mas463-cpu/ECET-230-Project/tasks/README.md

# Task List

## High Priority
- Interface MPU6050 with Arduino Leonardo
- Read and process gyroscope data
- Map motion data to cursor movement
- Implement mouse click functionality

## Medium Priority
- Implement scroll functionality
- Add cursor reset feature
- Tune sensitivity and smoothing

## Low Priority
- Add LED status indicator
- Improve ergonomics of device
- Clean up code and documentation

## Dependencies
- Gyroscope must be functioning before cursor mapping
- USB HID mouse functionality must be implemented before testing

## Completed Tasks

- Created initial KiCad schematic
- Added ATmega32U4 microcontroller connections
- Added MPU6050 gyroscope interface
- Routed USB D+ and D- traces
- Added 3.3V power routing and ground plane
- Completed multi-layer PCB routing
- Uploaded PCB screenshots and project documentation
