mas463-cpu/ECET-230-Project/AirMouse.png

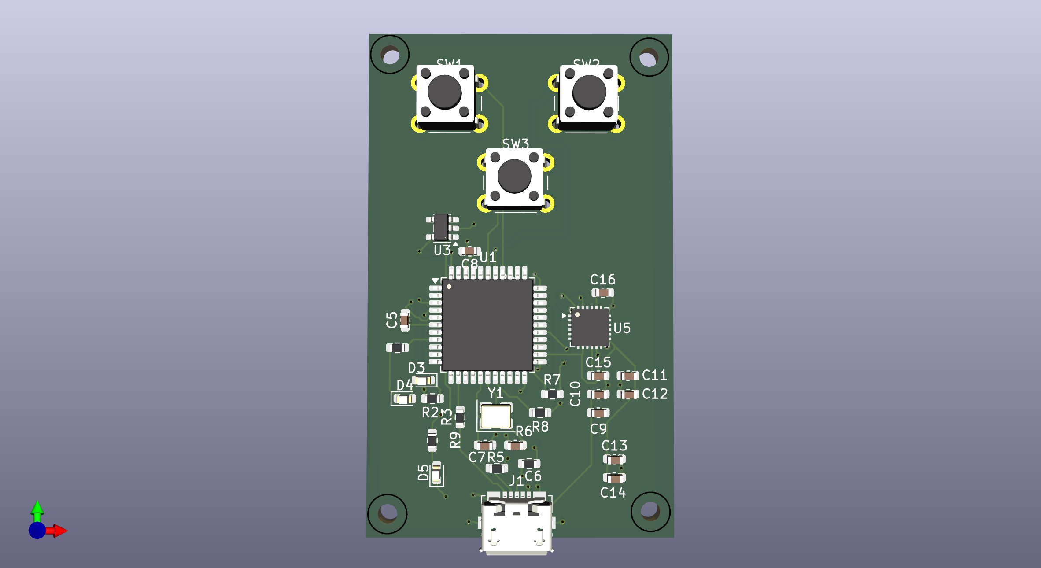
AirMouse.png
