mas463-cpu/ECET-230-Project/SchematicPlot.pdf

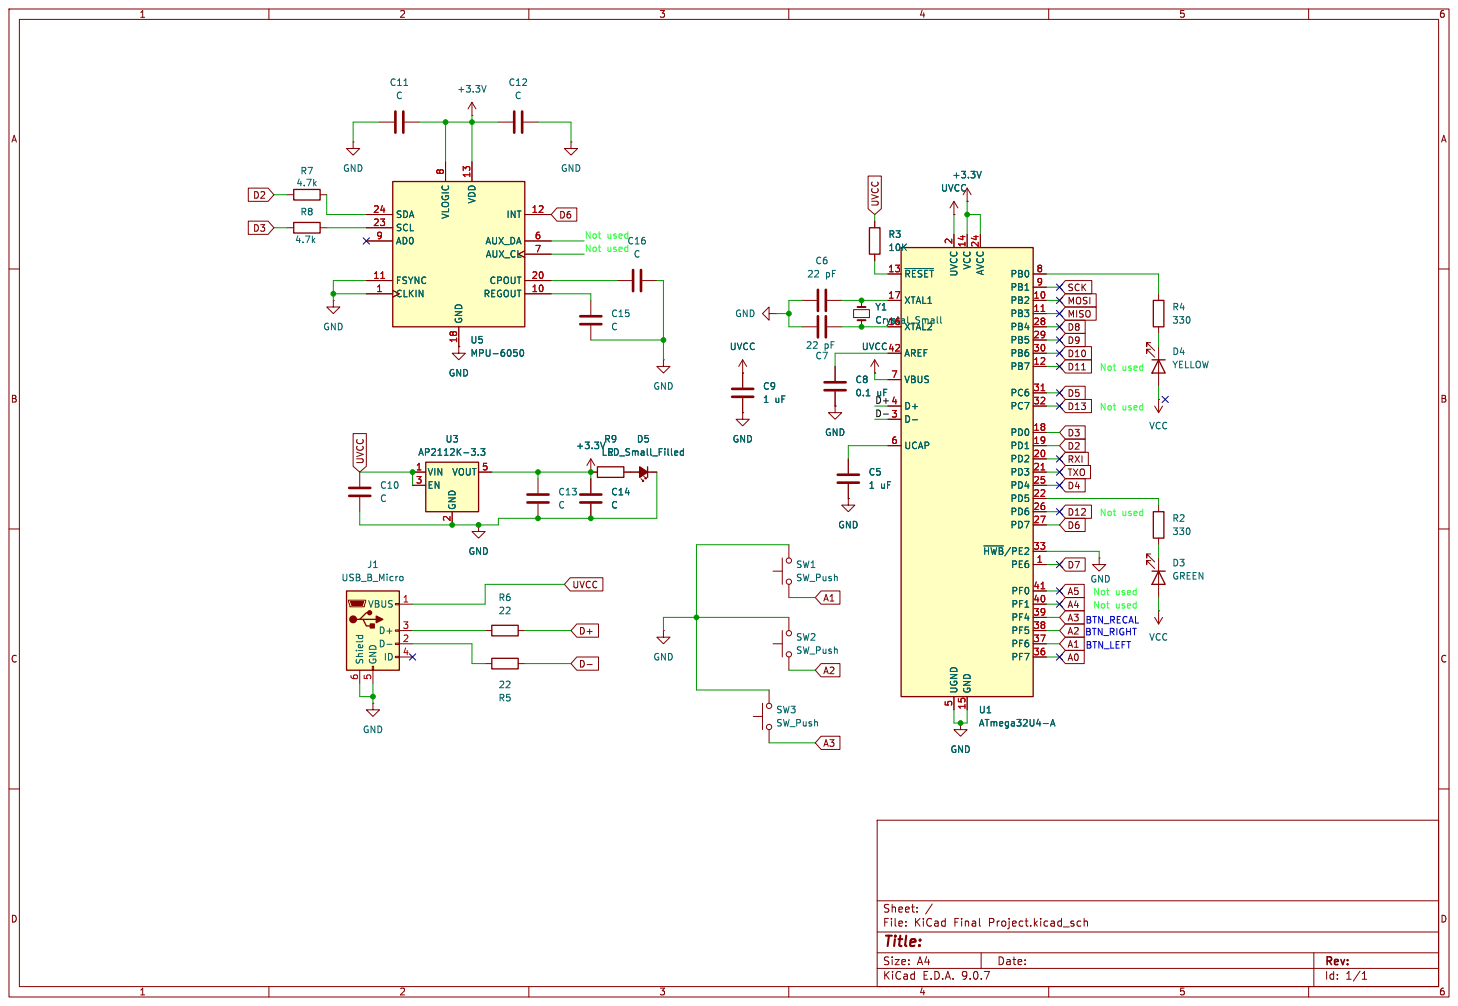
[picture p3: page 1]
