mas463-cpu/ECET-230-Project/logbook/README.md

# Project Logbook

## Project Idea
The goal of this project is to design an air mouse that allows a user to control a computer cursor by pointing a handheld device at the screen.

## Initial Planning
- Selected Arduino Leonardo due to USB HID capability
- Selected MPU6050 for motion sensing
- Decided to include physical buttons for user input

## Design Progress
- Created block diagram
- Identified required hardware components
- Planned basic system functionality

- ## Schematic Development

- Created the schematic design in KiCad using the ATmega32U4 microcontroller
- Added the MPU6050 motion sensor for air mouse movement tracking
- Designed USB Micro connections for power and USB communication
- Added push buttons, LEDs, resistors, capacitors, and voltage regulation circuitry
- Configured crystal oscillator connections for stable clock timing
- Verified signal and power connections throughout the schematic
- Corrected wiring issues and updated component connections during development

## PCB Development

- Converted the schematic into a PCB layout using KiCad PCB Editor
- Positioned components to reduce routing congestion and improve organization
- Routed USB D+ and D- traces between the USB connector and microcontroller
- Added vias and multi-layer routing to simplify PCB trace paths
- Implemented a full-board ground plane for grounding and routing efficiency
- Routed 3.3V and UVCC power connections across the board
- Adjusted component placement and traces to reduce air wire crossings
- Finalized PCB routing with all unrouted connections completed
- Generated PCB screenshots and archived final KiCad project files for presentation purposes

## Notes
- Cursor drift may require calibration
- Sensitivity tuning will be needed for smooth movement\

# Firmware Development

- Implemented USB HID mouse communication using the ATmega32U4
- Read MPU6050 gyroscope data over I2C communication
- Added startup gyro calibration using averaged still samples
- Implemented adaptive bias correction to reduce long-term cursor drift
- Added deadzone filtering to suppress small unwanted movements
- Added motion smoothing to improve cursor stability
- Implemented left click, right click, and recalibration button handling
- Tuned cursor scaling values for more natural movement

# Challenges and Fixes

## Cursor Drift
- Raw gyroscope values slowly drifted over time even while the device was stationary
- Added startup calibration and adaptive bias correction while device is still

## Cursor Jitter
- Small sensor fluctuations caused unstable cursor movement
- Added deadzone filtering and exponential smoothing

## Button Handling
- Rapid polling caused unstable click behavior
- Implemented edge-detection logic for cleaner button presses

## I2C Communication Stability
- Sensor communication occasionally became unstable
- Added pull-up resistors and improved I2C timing configuration

# Lessons Learned

- Raw IMU data requires significant filtering before it becomes usable
- Firmware processing became more important than expected
- PCB layout and enclosure planning strongly affect each other
- Simplifying the project scope improved development progress
- Wired USB greatly reduced communication complexity
- Motion smoothing and calibration significantly improved usability

# Final Project Status

## Completed
- KiCad schematic
- PCB layout
- USB HID firmware
- MPU6050 integration
- Three-button interface
- 3D PCB render
- Enclosure concept
- BOM generation
- Gerber generation

## Remaining Work
- Physical PCB fabrication
- Final enclosure mounting
- Ergonomic testing
- Sensitivity refinement
