mas463-cpu/ECET-230-Project/(commit log)

2026-05-08 Create README.md for PCB Design documentation
    Added README.md for PCB design details and features.
2026-05-08 Upload final KiCad project files and PCB screenshots
    Added zipped KiCad project, schematic screenshots, PCB routing screenshots, and updated project assets for presentation and collaboration.
2026-05-08 Update logbook with schematic and PCB development progress
    Added sections for Schematic and PCB Development detailing design and routing processes.
2026-05-08 Update completed PCB and schematic tasks
    Document completed tasks related to the project.
2026-05-08 Add updated schematic and PCB routing revisions
    Uploaded PCB routing notes and design revision documentation for the ECET-230 Air Mouse Project.
2026-05-08 Add future improvements section to README
    Added a section for future improvements including cursor smoothing, battery support, PCB size reduction, Bluetooth functionality, and button ergonomics.
2026-05-14 BOM
    List of Materials Used
    [BillofMaterial (1).csv]
2026-05-14 PCB 3D Image
2026-05-14 Rename Screenshot 2026-05-07 223809.png to PCB 3D Image
2026-05-14 Gerber Files
2026-05-14 Finished KiCad Schematic and PCB
2026-05-14 Rename gerbers (1).zip to gerbers.zip
2026-05-14 Rename BillofMaterial (1).csv to BillofMaterial.csv
    [BillofMaterial.csv]
2026-05-15 Revise microcontroller and LED information in user guide
    Updated microcontroller reference and clarified LED descriptions.
2026-05-15 Add Air Mouse testing documentation
    Documented the testing process and results for the Air Mouse, covering hardware verification, sensor testing, cursor movement, button functionality, and stress testing.
2026-05-15 Add project definition for Air Mouse
    Document the project definition for the Air Mouse, including objectives, hardware, software goals, design decisions, and current status.
